ahmedkhaledismail/8-bit-computer/README.md

# 8-bit Computer
> This repository documents the Ben Eater 8-bit computer schematics and notes on the working principles.

## Acknowledgment
That project is inspired by Ben Eater 8 bit computer video series. All the schematics in this repository are his work. You can find the project video tutorials and schematics on the Ben Eater website: [Ben Eater 8-bit computer](https://eater.net/8bit)
<br>

## Project Specifications
That 8-bit computer consists of the following modules: 
<ul>
<li>Clock Generator</li>
<li> 6 registers: 2 common purpose registers which are A-register and B-register, an Instruction Register (IR), Memory Address Register (MAR), Program counter, and an Output register.</li>
<li> 16-byte Random Access Memory (RAM)</li>
<li> Arithemtic Logic Unit</li>
<li> Control Logic Unit</li>
</ul>

To find my notes on the working principles of the modules, you go can to the [modules](/modules/) section.
<br>

## 8-bit Computer on Breadboards
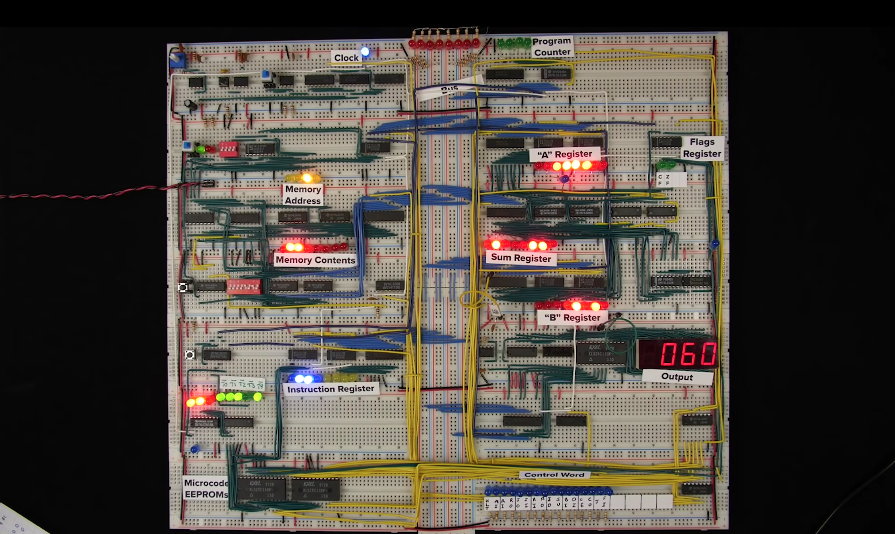
[picture p1: modules/CPU control logic/schematics/computer on breadboard.png]
 
<br>

## 8-bit Computer Schematic
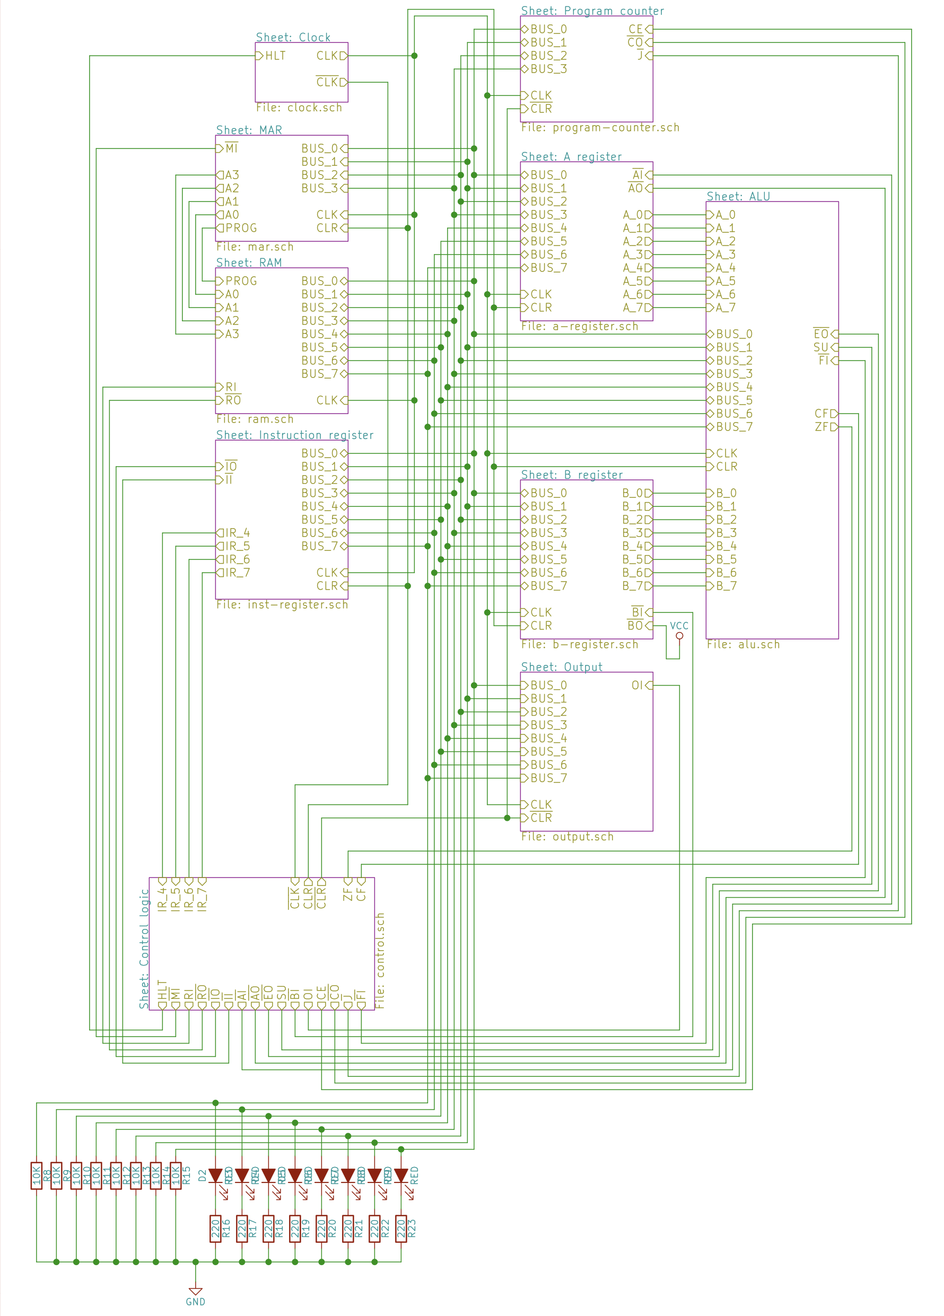
[picture p2: modules/CPU control logic/schematics/computer .png]
 

## Modules Schematics
### &nbsp;&nbsp;&nbsp;&nbsp; Clock Generator
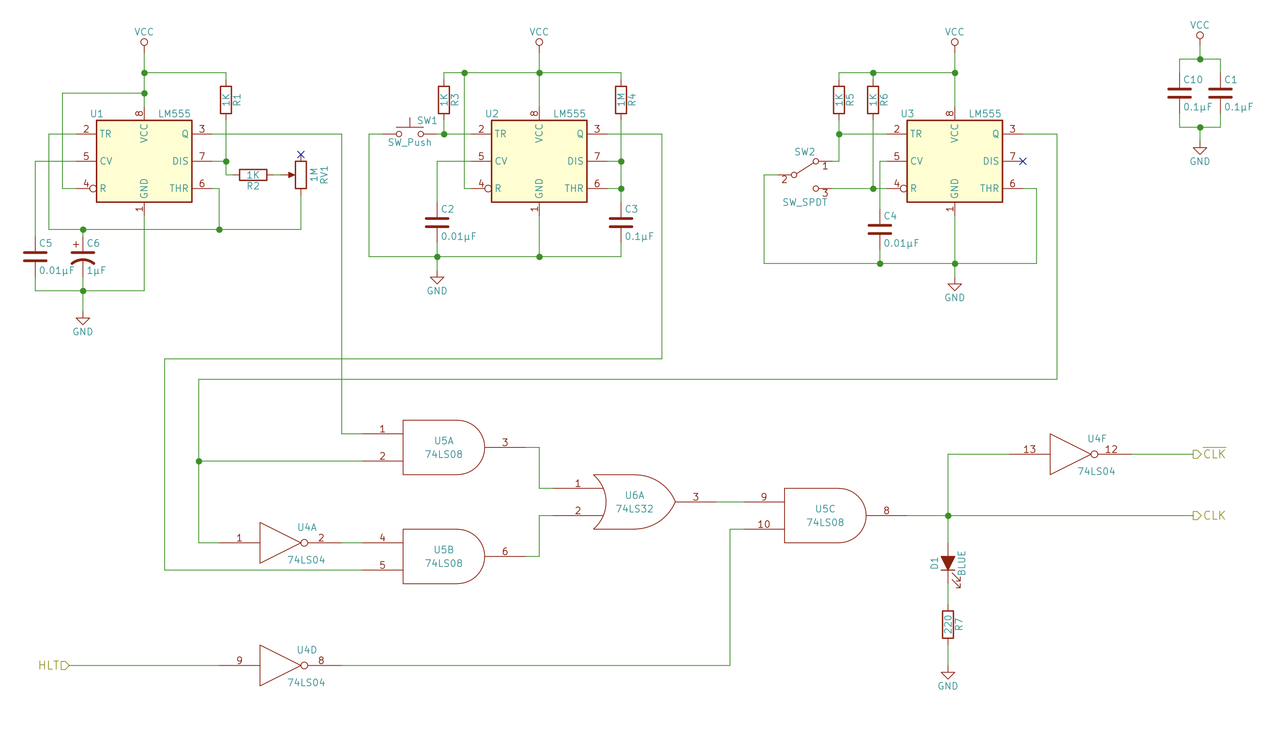
[picture p3: modules/Clock module/schematics/clock module.png]
 

### &nbsp;&nbsp;&nbsp;&nbsp; A Register
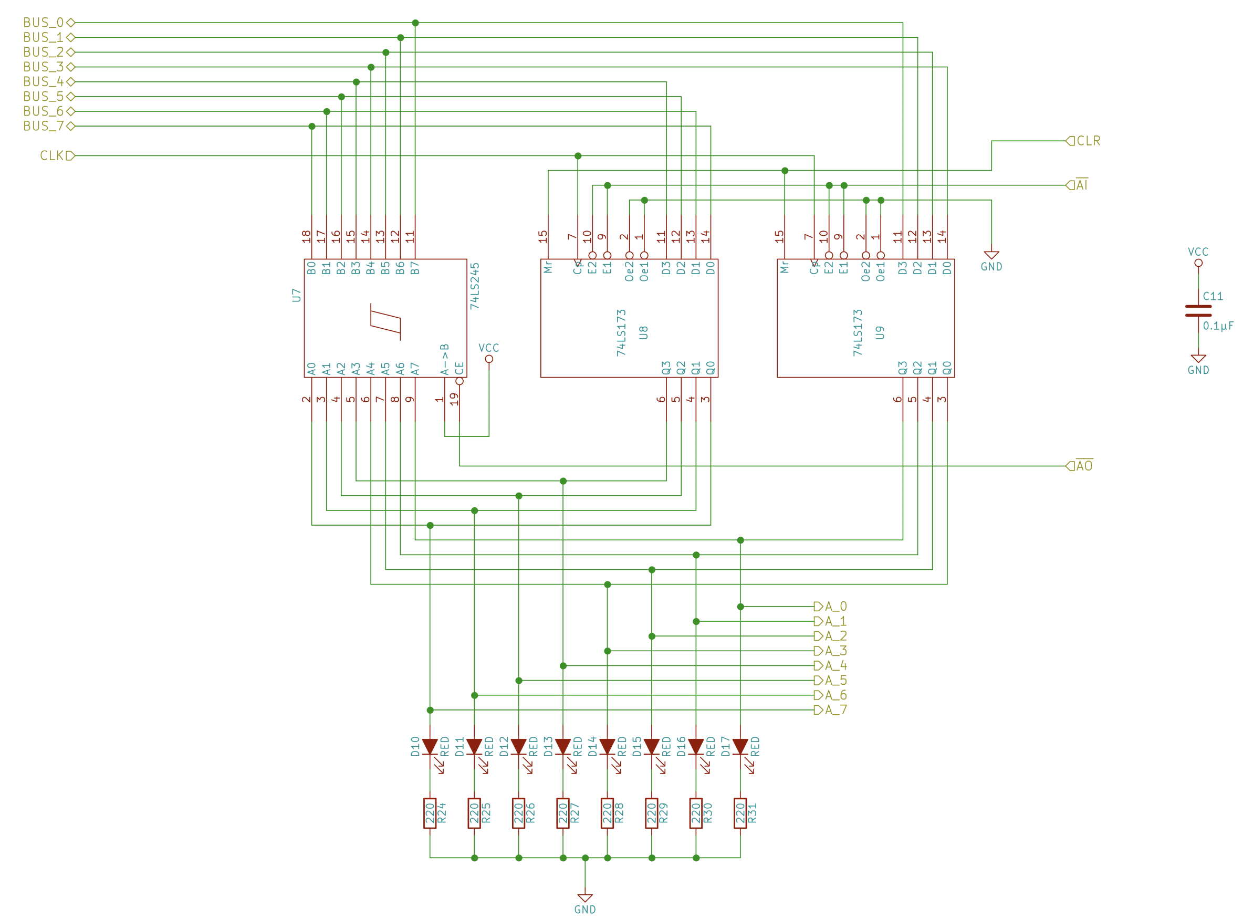
[picture p4: modules/Registers/schematics/a-register.png]
 

### &nbsp;&nbsp;&nbsp;&nbsp; B Register
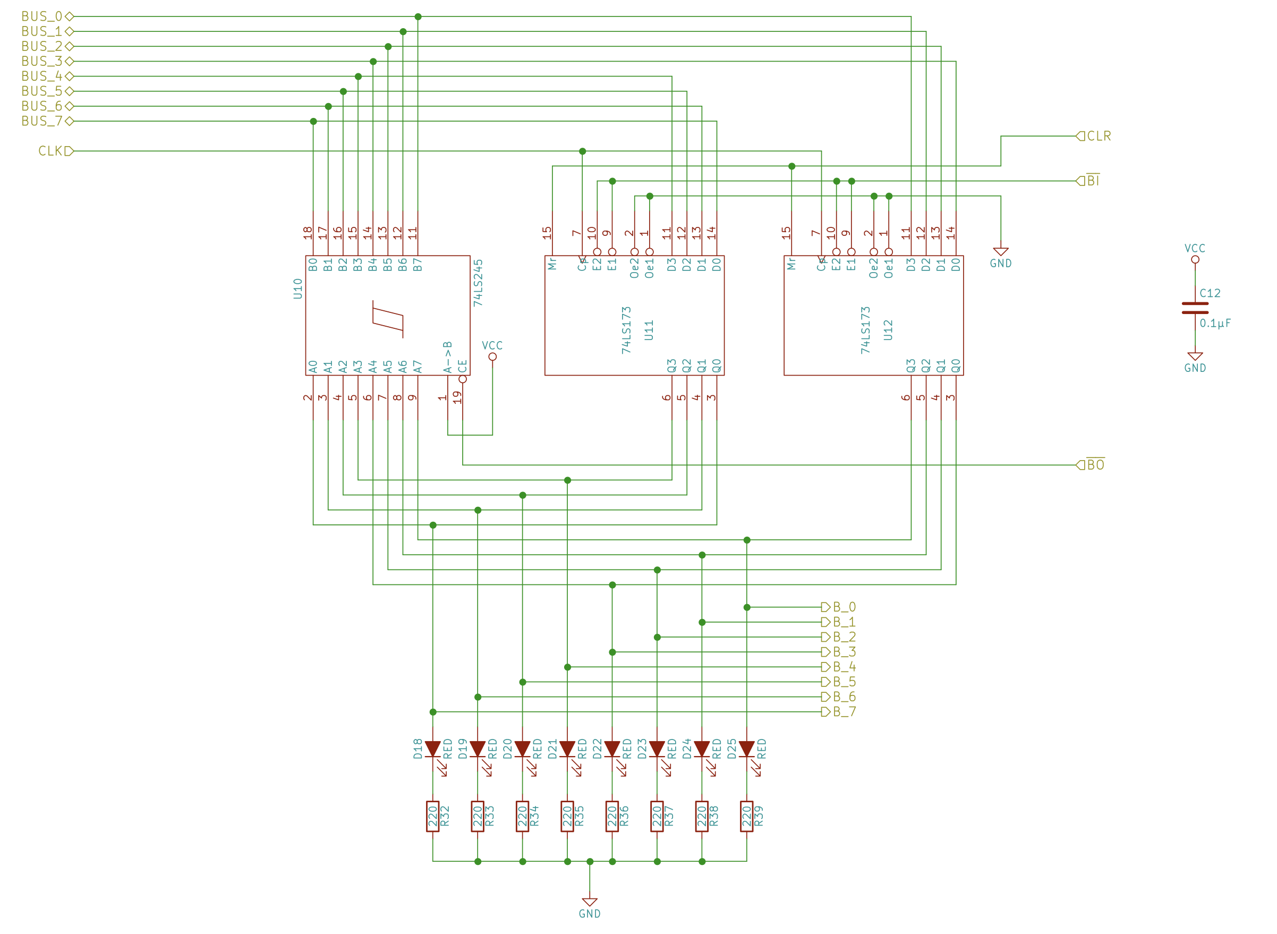
[picture p5: modules/Registers/schematics/b-register.png]


### &nbsp;&nbsp;&nbsp;&nbsp; Instruction Register
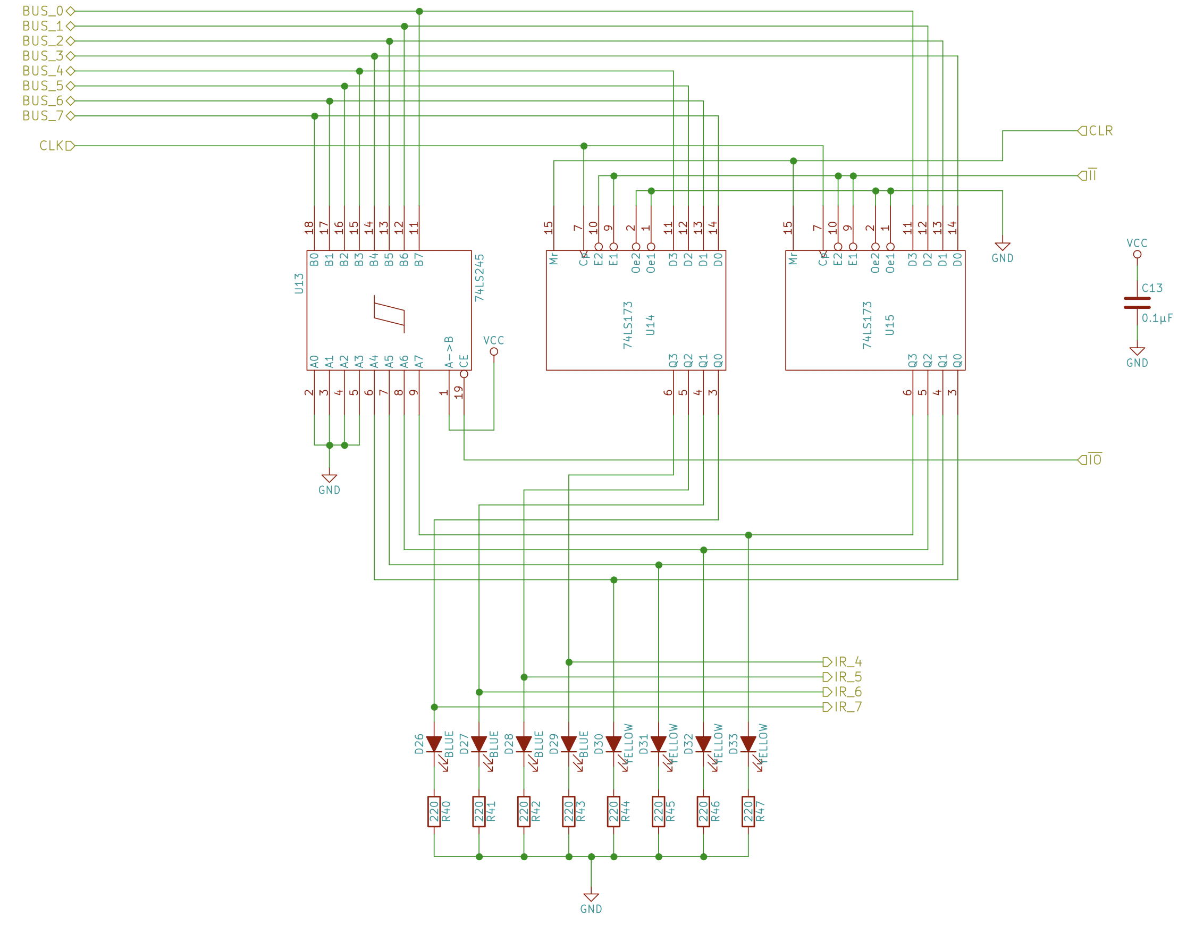
[picture p6: modules/Registers/schematics/instruction-register.png]
 

### &nbsp;&nbsp;&nbsp;&nbsp; Arithmetic logic unit (ALU)
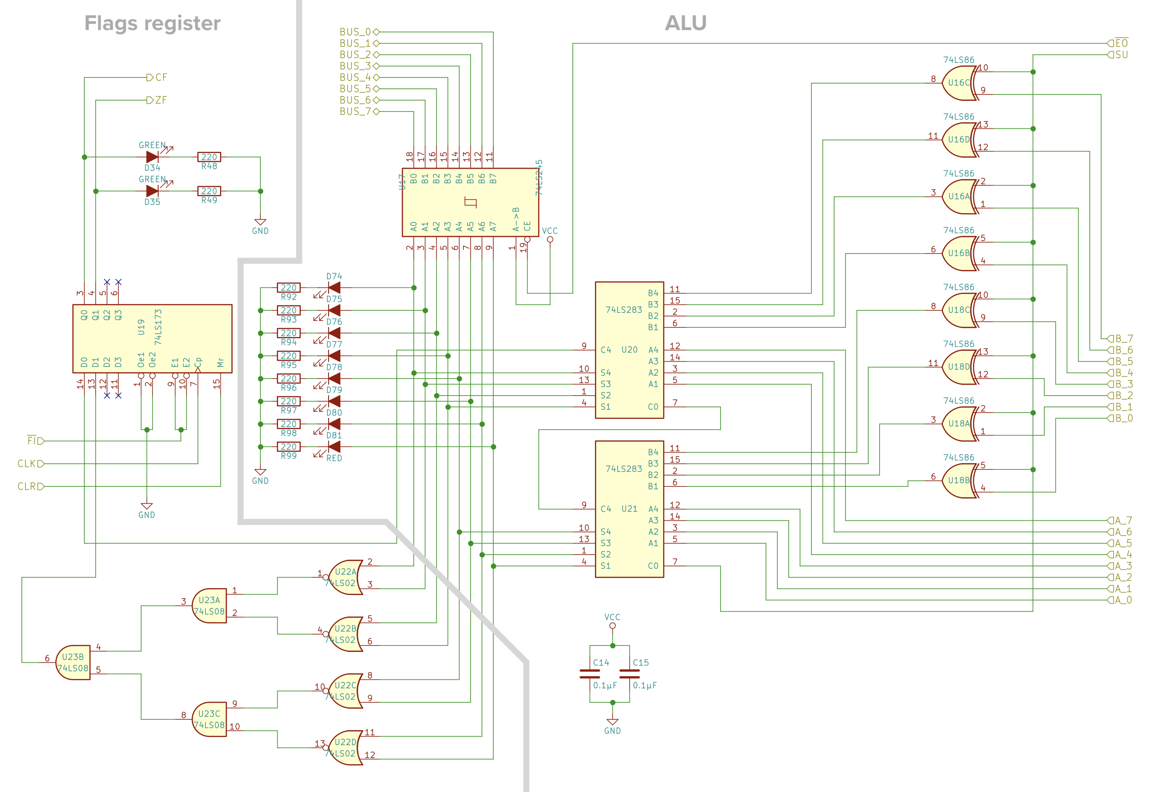
[picture p7: modules/Arithmetic logic unit (ALU)/schematics/alu.png]
 

### &nbsp;&nbsp;&nbsp;&nbsp; Random access memory (RAM) 
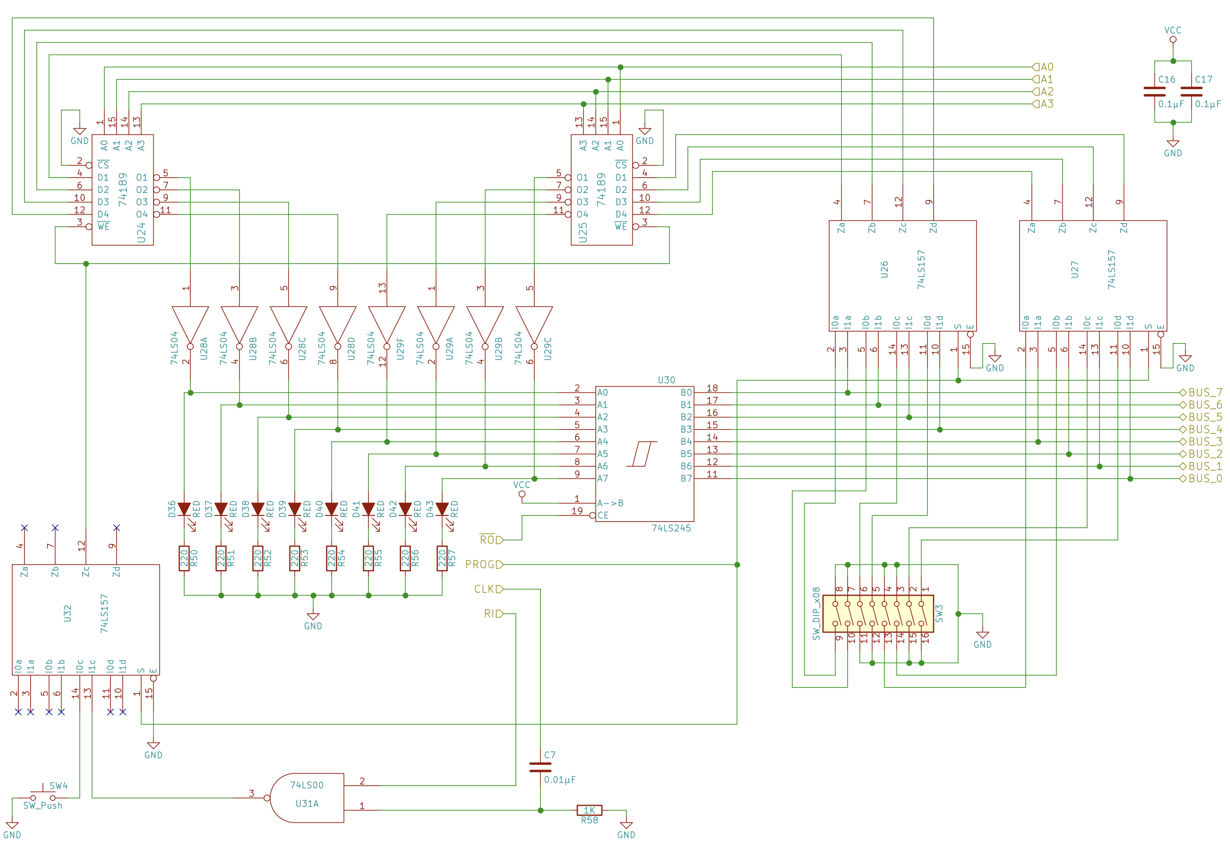
[picture p8: modules/Random access memory (RAM) module/schematics/ram module.png]
 

### &nbsp;&nbsp;&nbsp;&nbsp; Memory address register (MAR)
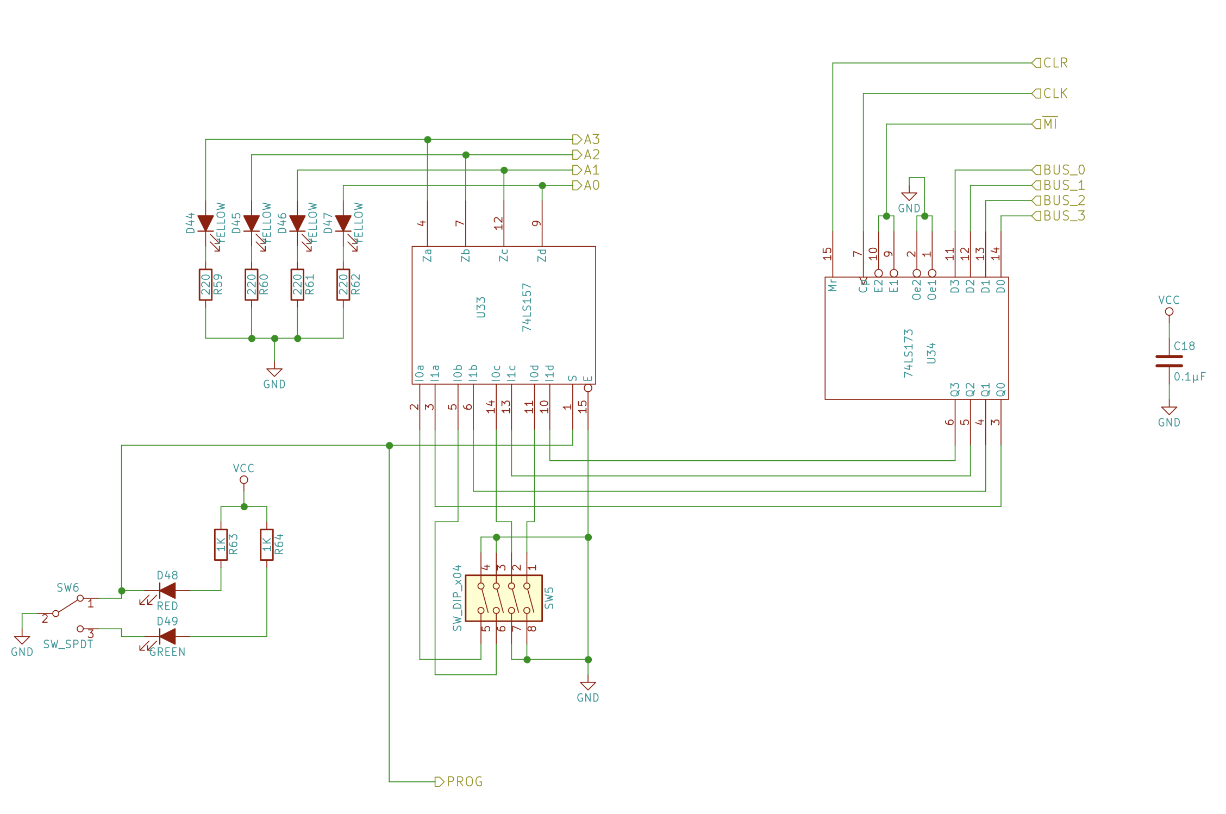
[picture p9: modules/Random access memory (RAM) module/schematics/memory address register.png]
 

### &nbsp;&nbsp;&nbsp;&nbsp; Program counter
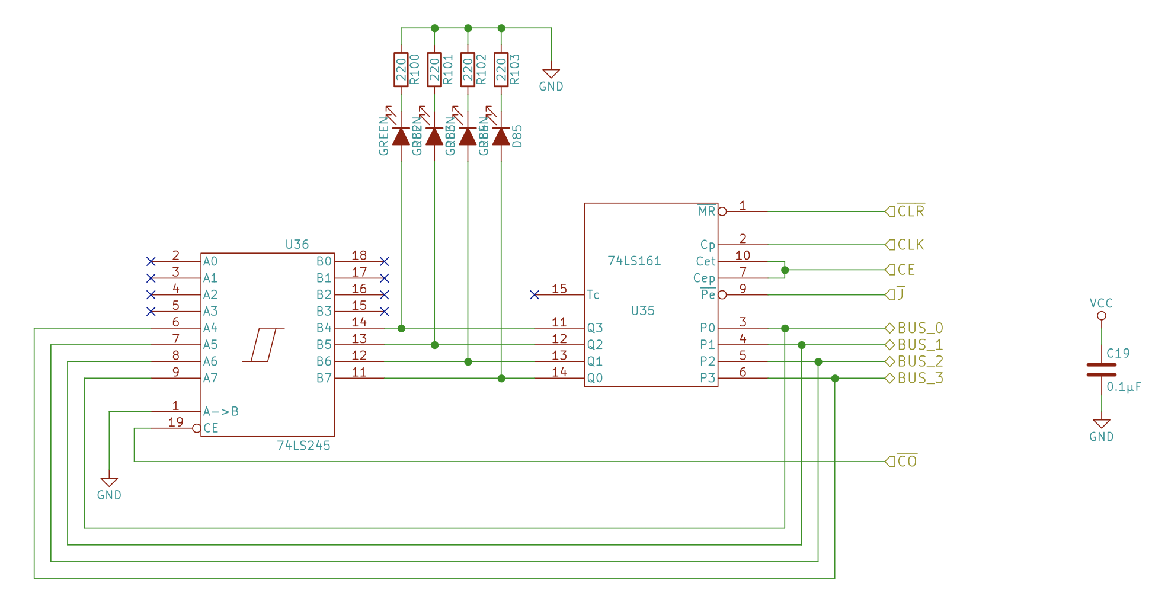
[picture p10: modules/Program counter/schematics/program counter.png]
 

### &nbsp;&nbsp;&nbsp;&nbsp; Output register
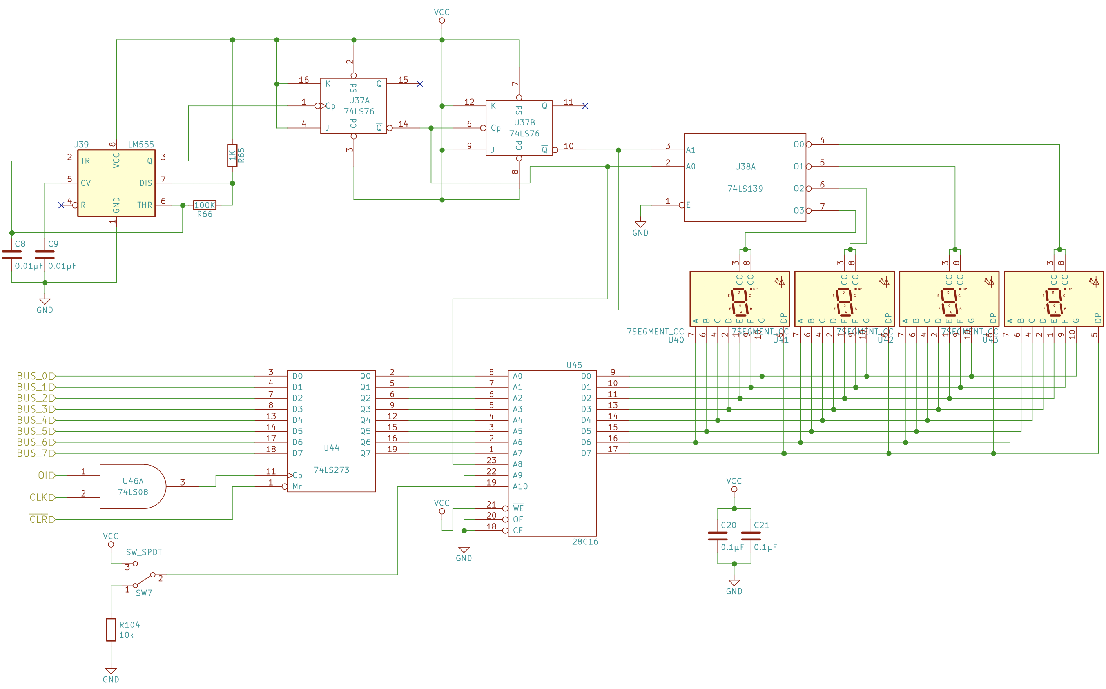
[picture p11: modules/Output register/schematics/output .png]
 

### &nbsp;&nbsp;&nbsp;&nbsp; CPU control logic
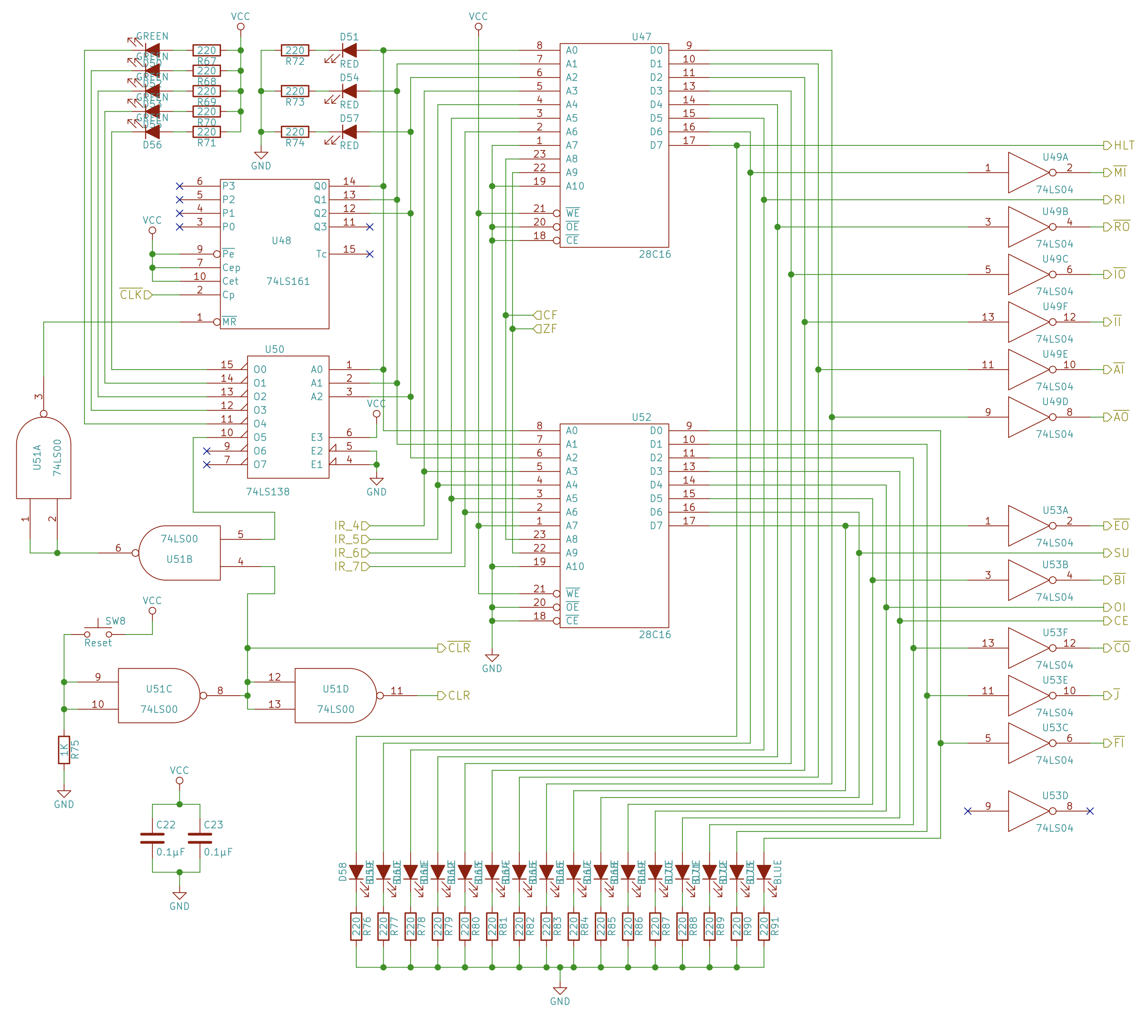
[picture p12: modules/CPU control logic/schematics/control.png]
