ahmedkhaledismail/8-bit-computer/(commit log)

2023-01-22 added clock module schematics
2023-01-23 added register module schematics
2023-01-23 added alu schematics
2023-01-24 added RAM module schematics
2023-01-24 added program counter module schematics
2023-01-25 added output register module schematic
2023-01-26 added control logic module schematics
